atticus88/SAINTCON-2015-Badge/saintcon2015-badge-lua/src/archive/README.md

Currently unused code that may still be useful. Most of this will be purged before going public with the code.
