atticus88/SAINTCON-2015-Badge/badge-2015/common/components/wifi/winc1500/firmware_update_project/firmware/Tools/gain_builder/gain_sheets/default_gain_setting.csv

ch | 1 | 2 | 3 | 4 | 5 | 6 | 7 | 8 | 9 | 10 | 11 | 12 | 13 | 14
1 | -11 | -11 | -11 | -11 | -11 | -11 | -11 | -11 | -11 | -11 | -11 | -11 | -11 | -11
2 | -11 | -11 | -11 | -11 | -11 | -11 | -11 | -11 | -11 | -11 | -11 | -11 | -11 | -11
5.5 | -10 | -10 | -10 | -10 | -10 | -10 | -10 | -10 | -10 | -10 | -10 | -10 | -10 | -10
11 | -10 | -10 | -10 | -10 | -10 | -10 | -10 | -10 | -10 | -10 | -10 | -10 | -10 | -10
6 | -6 | -6 | -6 | -6 | -6 | -6 | -6 | -6 | -6 | -6 | -6 | -6 | -6 | -6
9 | -6 | -6 | -6 | -6 | -6 | -6 | -6 | -6 | -6 | -6 | -6 | -6 | -6 | -6
12 | -6 | -6 | -6 | -6 | -6 | -6 | -6 | -6 | -6 | -6 | -6 | -6 | -6 | -6
18 | -6 | -6 | -6 | -6 | -6 | -6 | -6 | -6 | -6 | -6 | -6 | -6 | -6 | -6
24 | -6 | -6 | -6 | -6 | -6 | -6 | -6 | -6 | -6 | -6 | -6 | -6 | -6 | -6
36 | -8 | -8 | -8 | -8 | -8 | -8 | -8 | -8 | -8 | -8 | -8 | -8 | -8 | -8
48 | -10 | -10 | -10 | -10 | -10 | -10 | -10 | -10 | -10 | -10 | -10 | -10 | -10 | -10
54 | -10 | -10 | -10 | -10 | -10 | -10 | -10 | -10 | -10 | -10 | -10 | -10 | -10 | -10
mcs0 | -6 | -6 | -6 | -6 | -6 | -6 | -6 | -6 | -6 | -6 | -6 | -6 | -6 | -6
mcs1 | -6 | -6 | -6 | -6 | -6 | -6 | -6 | -6 | -6 | -6 | -6 | -6 | -6 | -6
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
