atticus88/SAINTCON-2015-Badge/badge-2015/common/components/wifi/winc1500/firmware_update_project/firmware/Tools/gain_builder/gain_sheets/samw25_gain_setting.csv

ch | 1 | 2 | 3 | 4 | 5 | 6 | 7 | 8 | 9 | 10 | 11 | 12 | 13 | 14
1 | -11.5 | -10 | -10 | -10 | -10 | -10 | -10 | -10 | -10 | -10 | -10 | -10 | -10.5 | -10.5
2 | -11.5 | -10 | -10 | -10 | -10 | -10 | -10 | -10 | -10 | -10 | -10 | -10 | -10.5 | -10.5
5.5 | -11.5 | -10 | -10 | -10 | -10 | -10 | -10 | -10 | -10 | -10 | -10 | -10 | -10.5 | -10.5
11 | -11.5 | -10 | -10 | -10 | -10 | -10 | -10 | -10 | -10 | -10 | -10 | -10 | -10.5 | -10.5
6 | -10 | -9.5 | -9.5 | -9.5 | -9.5 | -9.5 | -9.5 | -9.5 | -9.5 | -9.5 | -9.5 | -9.5 | -10 | -10
9 | -10 | -9.5 | -9.5 | -9.5 | -9.5 | -9.5 | -9.5 | -9.5 | -9.5 | -9.5 | -9.5 | -9.5 | -10 | -10
12 | -10 | -9.5 | -9.5 | -9.5 | -9.5 | -9.5 | -9.5 | -9.5 | -9.5 | -9.5 | -9.5 | -9.5 | -10 | -10
18 | -10 | -9.5 | -9.5 | -9.5 | -9.5 | -9.5 | -9.5 | -9.5 | -9.5 | -9.5 | -9.5 | -9.5 | -10 | -10
24 | -10 | -9.5 | -9.5 | -9.5 | -9.5 | -9.5 | -9.5 | -9.5 | -9.5 | -9.5 | -9.5 | -9.5 | -10 | -10
36 | -10 | -9.5 | -9.5 | -9.5 | -9.5 | -9.5 | -9.5 | -9.5 | -9.5 | -9.5 | -9.5 | -9.5 | -10 | -10
48 | -10 | -9.5 | -9.5 | -9.5 | -9.5 | -9.5 | -9.5 | -9.5 | -9.5 | -9.5 | -9.5 | -9.5 | -10 | -10
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
