atticus88/SAINTCON-2015-Badge/hardware/SaintCon2015Badge-20150830-sch.pdf

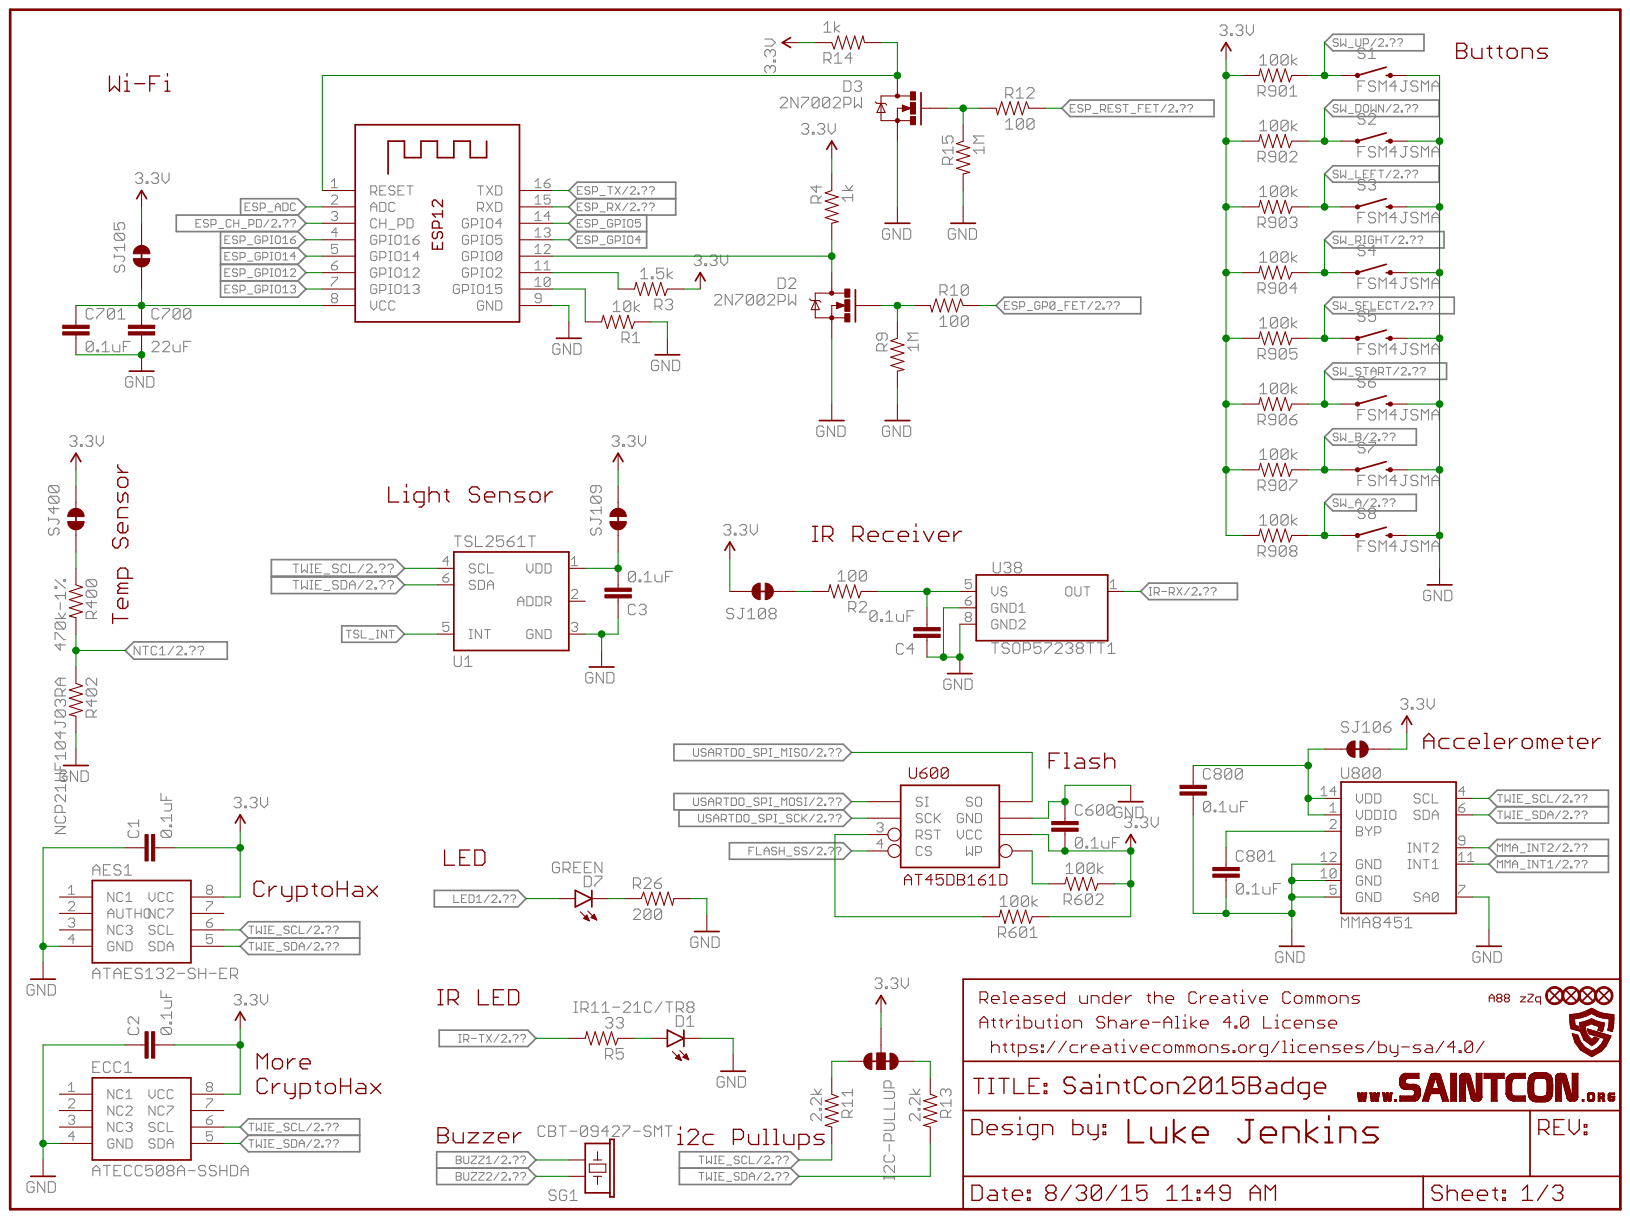
[picture p1: page 1]

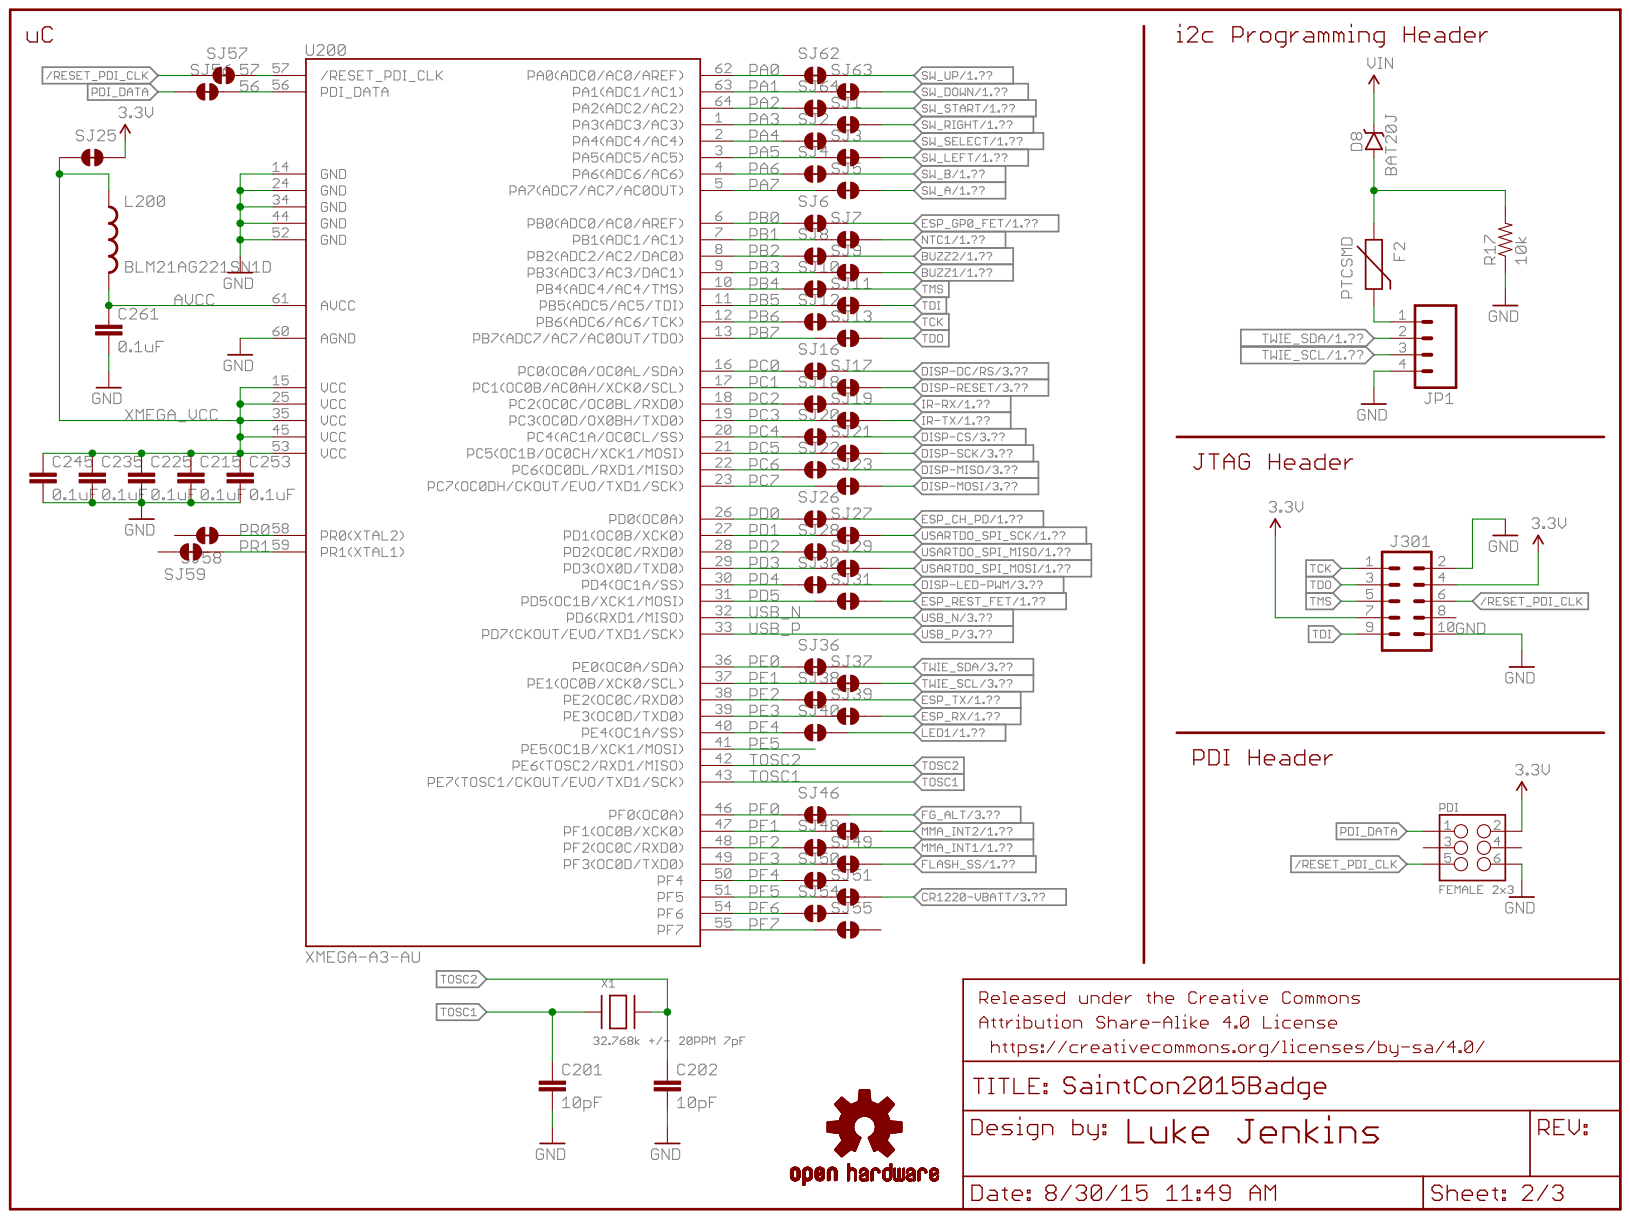
[picture p2: page 2]

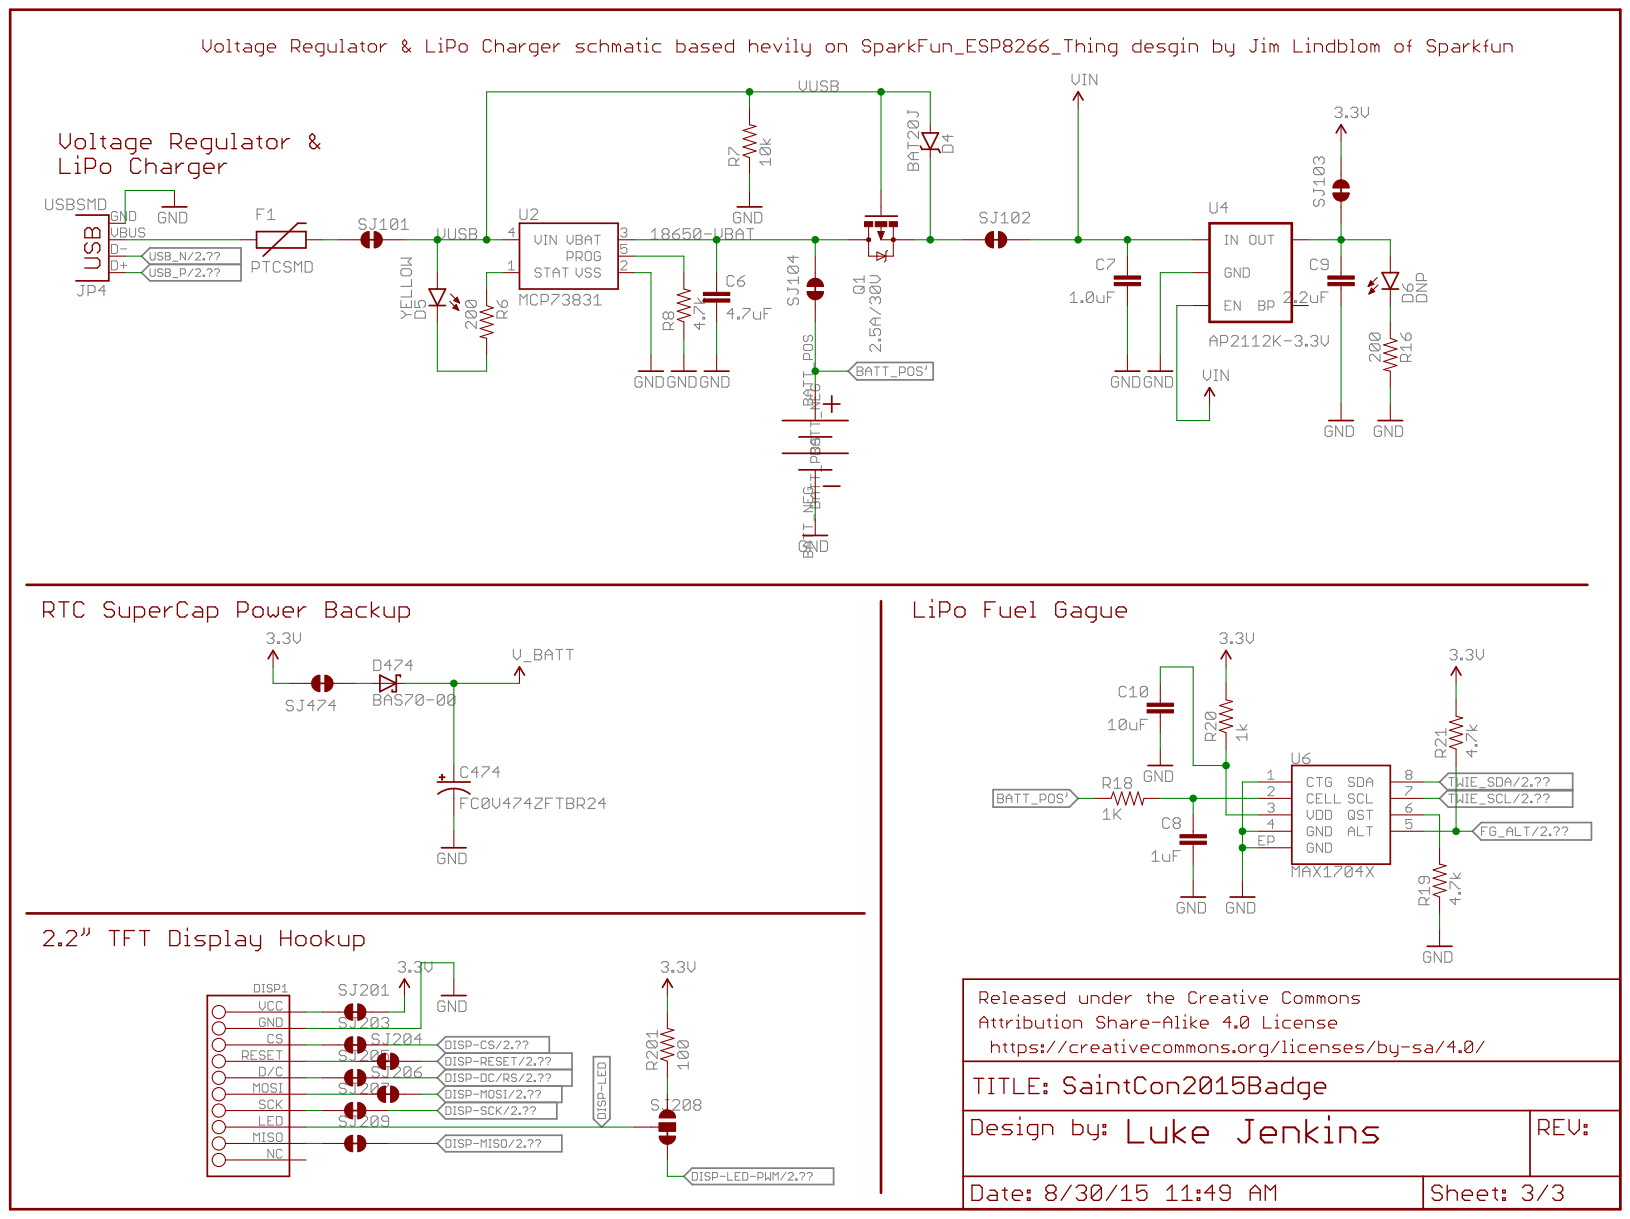
[picture p3: page 3]
