atticus88/SAINTCON-2015-Badge/hardware/SaintCon2015Badge.brd

## EAGLE design hardware/SaintCon2015Badge.brd (2015-10-31)

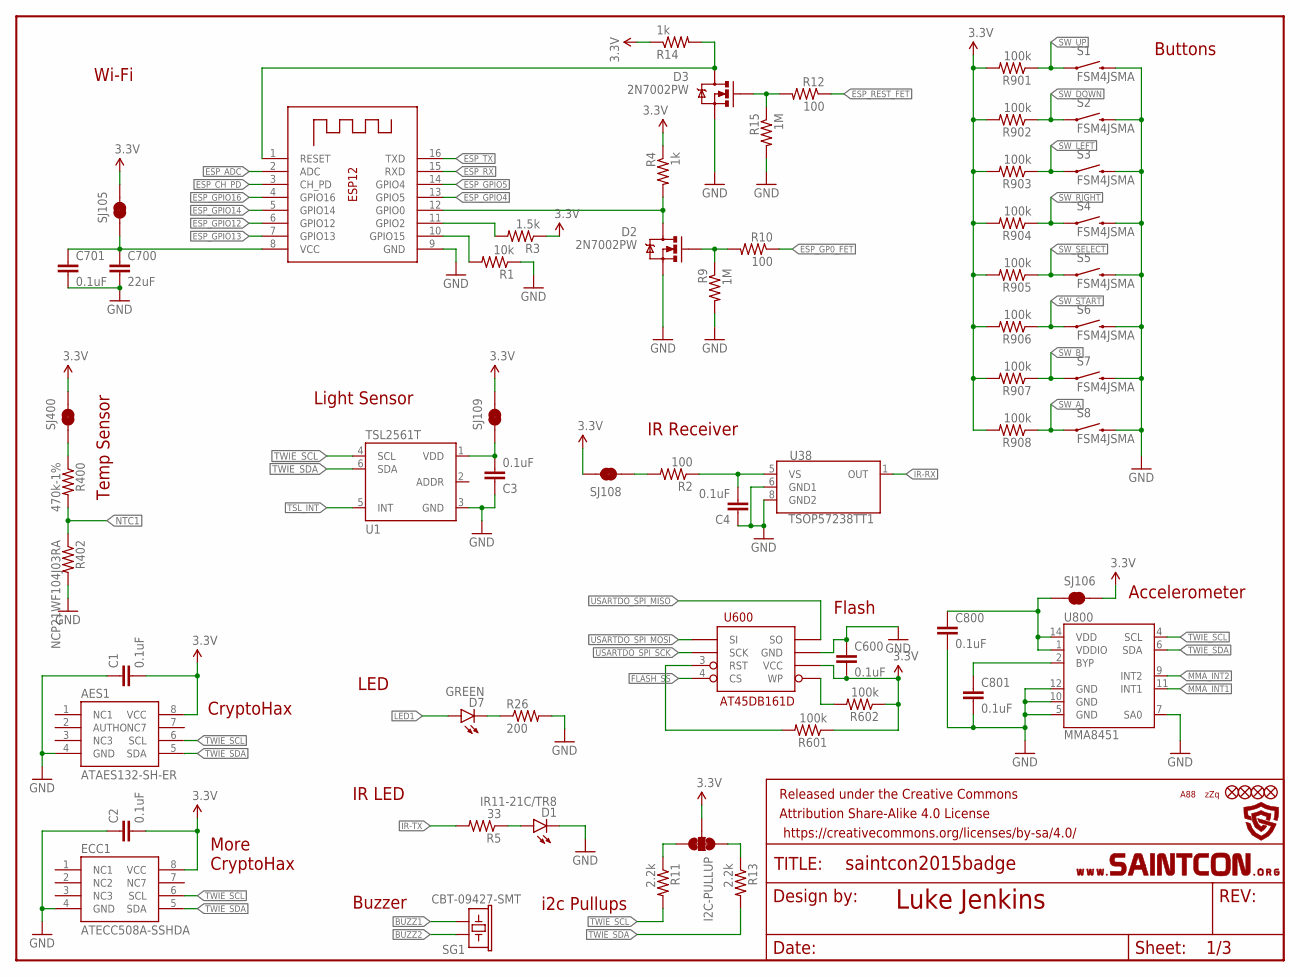
[picture p4: schematic SaintCon2015Badge.sch, sheet 1]

Parts:
AES1: ATAES132-SH-ER; SOIC8
C1, C2, C3, C4, C600, C701, C800, C801: 0.1uF; 0805
C700: 22uF; 0805
D1: IR11-21C/TR8; LED-1206
D2, D3: 2N7002PW; SOT323
D7: GREEN; LED-1206
ECC1: ATECC508A-SSHDA; SOIC8
ESP12: ESP12; ESP-12
FID1, FID2, FID3, FID4: FIDUCIAL1X2; FIDUCIAL-1X2
FRAME3: FRAME-LETTERNO_PACKAGE; DUMMY
I2C-PULLUP: JUMPER-PAD-3-NC_BY_TRACE; PAD-JUMPER-3-3OF3_NC_BY_TRACE_YES_SILK_FULL_BOX
R1: 10k; 0805
R2, R10, R12: 100; 0805
R3: 1.5k; 0805
R4, R14: 1k; 0805
R5: 33; 0805
R9, R15: 1M; 0805
R11, R13: 2.2k; 0805
R26: 200; 0805
R400: 470k-1%; 0805
R402: NCP21WF104J03RA; 0805
R601, R602, R901, R902, R903, R904, R905, R906, R907, R908: 100k; 0805
S1, S2, S3, S4, S5, S6, S7, S8: FSM4JSMA; TACTILE_SWITCH_ZZQ
SG1: CBT-09427-SMT; BUZZER-CCV-KIT
SJ105, SJ106, SJ108, SJ109, SJ400: JUMPER-PAD-2-NC_BY_TRACE; PAD-JUMPER-2-NC_BY_TRACE_YES_SILK
U1: TSL2561T; TMB-6
U38: TSOP57238TT1; TSOP572
U600: AT45DB161D; SO08-EIAJ
U800: MMA8451; QFN-16_0.5MM
U$1: AZZQ
U$2: A88
U$4: SAINTCON-LOGO
U$5: SAINTCON-HEADER

Connections:
3.3V: AES1.8 (VCC), C1.2, C2.2, C600.2, ECC1.8 (VCC), I2C-PULLUP.2, R3.1, R4.1, R14.1, R601.1, R602.1, R901.2, R902.2, R903.2, R904.2, R905.2, R906.2, R907.2, R908.2, SJ105.2, SJ106.2, SJ108.2, SJ109.2, SJ400.2, U600.6 (VCC); also elsewhere on the board
AT45-/RST: R601.2, U600.3 (RST)
AT45-/WP: R602.2, U600.5 (WP)
BUZZ1: SG1.+ (1); also elsewhere on the board
BUZZ2: SG1.- (2); also elsewhere on the board
D7-R26: D7.C, R26.1
ESP_ADC: ESP12.2 (ADC)
ESP_CH_PD: ESP12.3 (CH_PD); also elsewhere on the board
ESP_GP0_FET: R10.1; also elsewhere on the board
ESP_GPIO0: D2.3 (D), ESP12.12 (GPIO0), R4.2
ESP_GPIO0_FET_GATE: D2.1 (G), R9.1, R10.2
ESP_GPIO2: ESP12.11 (GPIO2), R3.2
ESP_GPIO4: ESP12.13 (GPIO5)
ESP_GPIO5: ESP12.14 (GPIO4)
ESP_GPIO12: ESP12.6 (GPIO12)
ESP_GPIO13: ESP12.7 (GPIO13)
ESP_GPIO14: ESP12.5 (GPIO14)
ESP_GPIO15: ESP12.10 (GPIO15), R1.2
ESP_GPIO16: ESP12.4 (GPIO16)
ESP_REST: D3.3 (D), ESP12.1 (RESET), R14.2
ESP_REST_FET: R12.1; also elsewhere on the board
ESP_REST_FET_GATE: D3.1 (G), R12.2, R15.1
ESP_RX: ESP12.15 (RXD); also elsewhere on the board
ESP_TX: ESP12.16 (TXD); also elsewhere on the board
ESP_VCC: C700.1, C701.1, ESP12.8 (VCC), SJ105.1
FLASH_SS: U600.4 (CS); also elsewhere on the board
GND: AES1.4 (GND), C1.1, C2.1, C3.1, C4.1, C600.1, C700.2, C701.2, C800.2, C801.2, D1.C, D2.2 (S), D3.2 (S), ECC1.4 (GND), ESP12.9 (GND), R1.1, R9.2, R15.2, R26.2, R402.2, S1.B2 (2), S2.B2 (2), S3.B2 (2), S4.B2 (2), S5.B2 (2), S6.B2 (2), S7.B2 (2), S8.B2 (2), U1.3 (GND), U38.6 (GND1), U38.8 (GND2), U600.7 (GND), U800.5 (GND), U800.7 (SA0), U800.10 (GND), U800.12 (GND); also elsewhere on the board
IR-RX: U38.1 (OUT); also elsewhere on the board
IR-RX-VS: C4.2, R2.1, U38.5 (VS)
IR-TX: R5.2; also elsewhere on the board
IR-TX-R: D1.A, R5.1
LED1: D7.A; also elsewhere on the board
MMA8451-BYP: C801.1, U800.2 (BYP)
MMA_INT1: U800.11 (INT1); also elsewhere on the board
MMA_INT2: U800.9 (INT2); also elsewhere on the board
MMA_VCC: C800.1, SJ106.1, U800.1 (VDDIO), U800.14 (VDD)
NTC1: R400.2, R402.1; also elsewhere on the board
R2-IN: R2.2, SJ108.1
R11-IN: I2C-PULLUP.3, R11.1
R13-IN: I2C-PULLUP.1, R13.1
R400-SJ400: R400.1, SJ400.1
SW_A: R908.1, S8.A2 (1); also elsewhere on the board
SW_B: R907.1, S7.A2 (1); also elsewhere on the board
SW_DOWN: R902.1, S2.A2 (1); also elsewhere on the board
SW_LEFT: R903.1, S3.A2 (1); also elsewhere on the board
SW_RIGHT: R904.1, S4.A2 (1); also elsewhere on the board
SW_SELECT: R905.1, S5.A2 (1); also elsewhere on the board
SW_START: R906.1, S6.A2 (1); also elsewhere on the board
SW_UP: R901.1, S1.A2 (1); also elsewhere on the board
TSL2561-VDD: C3.2, SJ109.1, U1.1 (VDD)
TSL_INT: U1.5 (INT)
TWIE_SCL: AES1.6 (SCL), ECC1.6 (SCL), R11.2, U1.4 (SCL), U800.4 (SCL); also elsewhere on the board
TWIE_SDA: AES1.5 (SDA), ECC1.5 (SDA), R13.2, U1.6 (SDA), U800.6 (SDA); also elsewhere on the board
USARTDO_SPI_MISO: U600.8 (SO); also elsewhere on the board
USARTDO_SPI_MOSI: U600.1 (SI); also elsewhere on the board
USARTDO_SPI_SCK: U600.2 (SCK); also elsewhere on the board

Notes on the sheet:
Luke Jenkins
Wi-Fi
Temp Sensor
CryptoHax
LED
IR LED
i2c Pullups
Buzzer
Accelerometer
Flash
Light Sensor
IR Receiver
Buttons
More CryptoHax

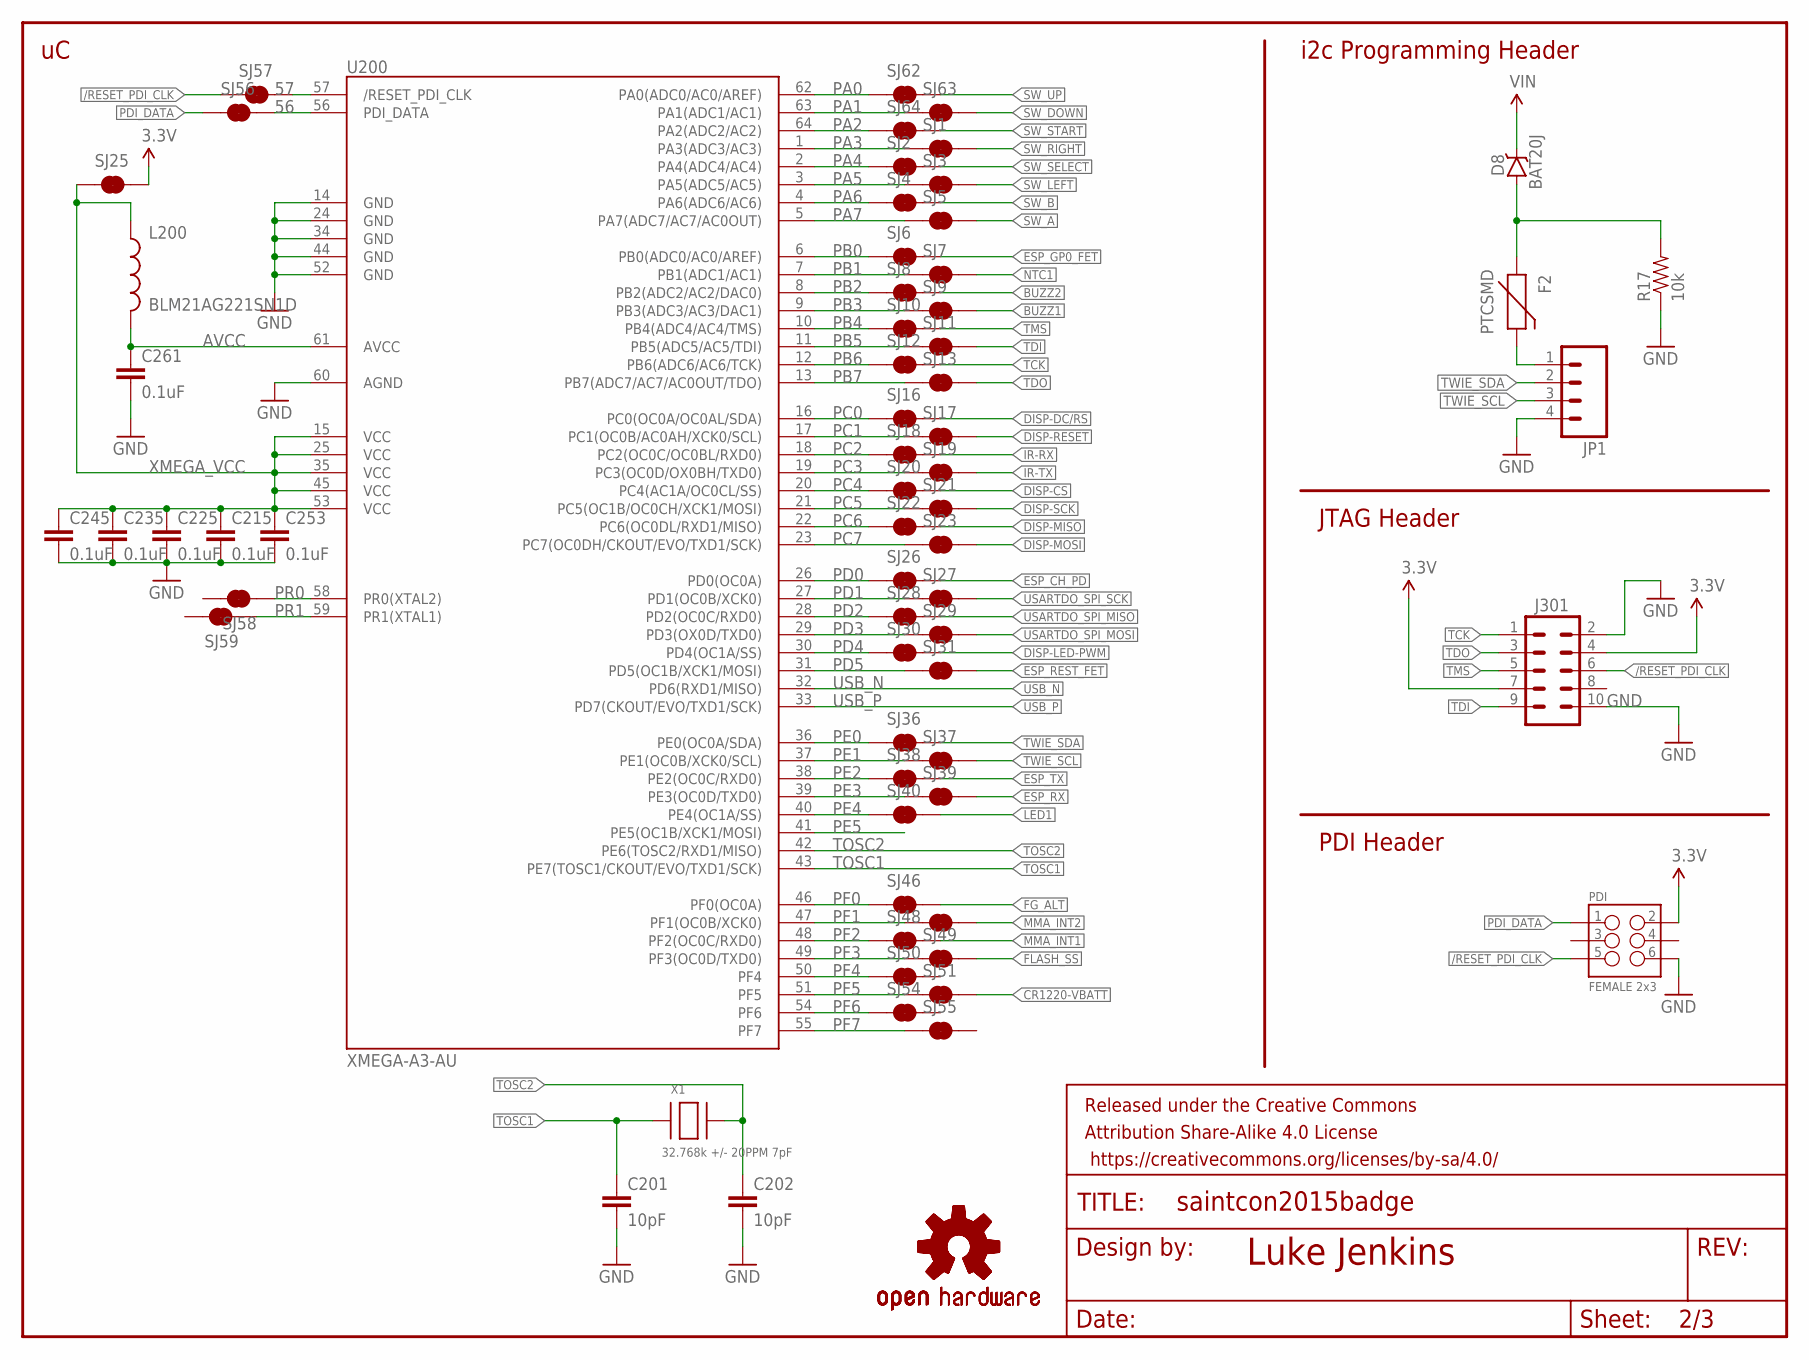
[picture p5: schematic SaintCon2015Badge.sch, sheet 2]

Parts:
C201, C202: 10pF; 0805
C215, C225, C235, C245, C253, C261: 0.1uF; 0805
D8: BAT20J; SOD-323
F2: PTCSMD; PTC-1206
FRAME1: FRAME-LETTERNO_PACKAGE; DUMMY
J301: M05X2PTH; AVR_ICSP
JP1: M04PTH; 1X04
L200: BLM21AG221SN1D; 0805
LOGO1: OSHW-LOGOS-COPPER; OSHW-LOGO-S_COPPER
LOGO2: OSHW-LOGOS; OSHW-LOGO-S
PDI: FEMALE 2x3; 2X3
R17: 10k; 0805
SJ1, SJ2, SJ3, SJ4, SJ5, SJ6, SJ7, SJ8, SJ9, SJ10, SJ11, SJ12, SJ13, SJ16, SJ17, SJ18, SJ19, SJ20, SJ21, SJ22, SJ23, SJ25, SJ26, SJ27, SJ28, SJ29, SJ30, SJ31, SJ36, SJ37, SJ38, SJ39, SJ40, SJ46, SJ47, SJ48, SJ49, SJ50, SJ51, SJ54, SJ55, SJ56, SJ57, SJ58, SJ59, SJ62, SJ63, SJ64: JUMPER-PAD-2-NC_BY_TRACE; PAD-JUMPER-2-NC_BY_TRACE_YES_SILK
U200: XMEGA-A3-AU; TQFP64_14X14MM
X1: 32.768k +/- 20PPM 7pF; XTAL3215

Connections:
3.3V: J301.4, J301.7, PDI.2, SJ25.2; also elsewhere on the board
56: SJ56.2, U200.56 (PDI_DATA)
57: SJ57.2, U200.57 (/RESET_PDI_CLK)
/RESET_PDI_CLK: J301.6, PDI.5, SJ57.1
AVCC: C261.1, L200.2, U200.61 (AVCC)
BUZZ1: SJ9.2; also elsewhere on the board
BUZZ2: SJ8.2; also elsewhere on the board
CR1220-VBATT: SJ51.2; also elsewhere on the board
DISP-CS: SJ20.2; also elsewhere on the board
DISP-DC/RS: SJ16.2; also elsewhere on the board
DISP-LED-PWM: SJ30.2; also elsewhere on the board
DISP-MISO: SJ22.2; also elsewhere on the board
DISP-MOSI: SJ23.2; also elsewhere on the board
DISP-RESET: SJ17.2; also elsewhere on the board
DISP-SCK: SJ21.2; also elsewhere on the board
ESP_CH_PD: SJ26.2; also elsewhere on the board
ESP_GP0_FET: SJ6.2; also elsewhere on the board
ESP_REST_FET: SJ31.2; also elsewhere on the board
ESP_RX: SJ39.2; also elsewhere on the board
ESP_TX: SJ38.2; also elsewhere on the board
F2-D8-R17: D8.A, F2.1, R17.2
FG_ALT: SJ46.2; also elsewhere on the board
FLASH_SS: SJ49.2; also elsewhere on the board
GND: C201.2, C202.2, C215.2, C225.2, C235.2, C245.2, C253.2, C261.2, J301.2, J301.10, JP1.4, PDI.6, R17.1, U200.14 (GND1), U200.24 (GND2), U200.34 (GND3), U200.44 (GND4), U200.52 (GND5), U200.60 (AGND); also elsewhere on the board
IR-RX: SJ18.2; also elsewhere on the board
IR-TX: SJ19.2; also elsewhere on the board
J1-F2: F2.2, JP1.1
LED1: SJ40.2; also elsewhere on the board
MMA_INT1: SJ48.2; also elsewhere on the board
MMA_INT2: SJ47.2; also elsewhere on the board
NTC1: SJ7.2; also elsewhere on the board
PA0: SJ62.1, U200.62 (PA0(ADC0/AC0/AREF))
PA1: SJ63.1, U200.63 (PA1(ADC1/AC1))
PA2: SJ64.1, U200.64 (PA2(ADC2/AC2))
PA3: SJ1.1, U200.1 (PA3(ADC3/AC3))
PA4: SJ2.1, U200.2 (PA4(ADC4/AC4))
PA5: SJ3.1, U200.3 (PA5(ADC5/AC5))
PA6: SJ4.1, U200.4 (PA6(ADC6/AC6))
PA7: SJ5.1, U200.5 (PA7(ADC7/AC7/AC0OUT))
PB0: SJ6.1, U200.6 (PB0(ADC0/AC0/AREF))
PB1: SJ7.1, U200.7 (PB1(ADC1/AC1))
PB2: SJ8.1, U200.8 (PB2(ADC2/AC2/DAC0))
PB3: SJ9.1, U200.9 (PB3(ADC3/AC3/DAC1))
PB4: SJ10.1, U200.10 (PB4(ADC4/AC4/TMS))
PB5: SJ11.1, U200.11 (PB5(ADC5/AC5/TDI))
PB6: SJ12.1, U200.12 (PB6(ADC6/AC6/TCK))
PB7: SJ13.1, U200.13 (PB7(ADC7/AC7/AC0OUT/TDO))
PC0: SJ16.1, U200.16 (PC0(OC0A/OC0AL/SDA))
PC1: SJ17.1, U200.17 (PC1(OC0B/AC0AH/XCK0/SCL))
PC2: SJ18.1, U200.18 (PC2(OC0C/OC0BL/RXD0))
PC3: SJ19.1, U200.19 (PC3(OC0D/OX0BH/TXD0))
PC4: SJ20.1, U200.20 (PC4(AC1A/OC0CL/SS))
PC5: SJ21.1, U200.21 (PC5(OC1B/OC0CH/XCK1/MOSI))
PC6: SJ22.1, U200.22 (PC6(OC0DL/RXD1/MISO))
PC7: SJ23.1, U200.23 (PC7(OC0DH/CKOUT/EVO/TXD1/SCK))
PD0: SJ26.1, U200.26 (PD0(OC0A))
PD1: SJ27.1, U200.27 (PD1(OC0B/XCK0))
PD2: SJ28.1, U200.28 (PD2(OC0C/RXD0))
PD3: SJ29.1, U200.29 (PD3(OX0D/TXD0))
PD4: SJ30.1, U200.30 (PD4(OC1A/SS))
PD5: SJ31.1, U200.31 (PD5(OC1B/XCK1/MOSI))
PDI_DATA: PDI.1, SJ56.1
PE0: SJ36.1, U200.36 (PE0(OC0A/SDA))
PE1: SJ37.1, U200.37 (PE1(OC0B/XCK0/SCL))
PE2: SJ38.1, U200.38 (PE2(OC0C/RXD0))
PE3: SJ39.1, U200.39 (PE3(OC0D/TXD0))
PE4: SJ40.1, U200.40 (PE4(OC1A/SS))
PE5: U200.41 (PE5(OC1B/XCK1/MOSI))
PF0: SJ46.1, U200.46 (PF0(OC0A))
PF1: SJ47.1, U200.47 (PF1(OC0B/XCK0))
PF2: SJ48.1, U200.48 (PF2(OC0C/RXD0))
PF3: SJ49.1, U200.49 (PF3(OC0D/TXD0))
PF4: SJ50.1, U200.50 (PF4)
PF5: SJ51.1, U200.51 (PF5)
PF6: SJ54.1, U200.54 (PF6)
PF7: SJ55.1, U200.55 (PF7)
PR0: SJ58.1, U200.58 (PR0(XTAL2))
PR1: SJ59.1, U200.59 (PR1(XTAL1))
SW_A: SJ5.2; also elsewhere on the board
SW_B: SJ4.2; also elsewhere on the board
SW_DOWN: SJ63.2; also elsewhere on the board
SW_LEFT: SJ3.2; also elsewhere on the board
SW_RIGHT: SJ1.2; also elsewhere on the board
SW_SELECT: SJ2.2; also elsewhere on the board
SW_START: SJ64.2; also elsewhere on the board
SW_UP: SJ62.2; also elsewhere on the board
TCK: J301.1, SJ12.2
TDI: J301.9, SJ11.2
TDO: J301.3, SJ13.2
TMS: J301.5, SJ10.2
TOSC1: C201.1, U200.43 (PE7(TOSC1/CKOUT/EVO/TXD1/SCK)), X1.P$1
TOSC2: C202.1, U200.42 (PE6(TOSC2/RXD1/MISO)), X1.P$2
TWIE_SCL: JP1.3, SJ37.2; also elsewhere on the board
TWIE_SDA: JP1.2, SJ36.2; also elsewhere on the board
USARTDO_SPI_MISO: SJ28.2; also elsewhere on the board
USARTDO_SPI_MOSI: SJ29.2; also elsewhere on the board
USARTDO_SPI_SCK: SJ27.2; also elsewhere on the board
USB_N: U200.32 (PD6(RXD1/MISO)); also elsewhere on the board
USB_P: U200.33 (PD7(CKOUT/EVO/TXD1/SCK)); also elsewhere on the board
VIN: D8.C; also elsewhere on the board
XMEGA_VCC: C215.1, C225.1, C235.1, C245.1, C253.1, L200.1, SJ25.1, U200.15 (VCC1), U200.25 (VCC2), U200.35 (VCC3), U200.45 (VCC4), U200.53 (VCC5)

Notes on the sheet:
Luke Jenkins
i2c Programming Header
JTAG Header
PDI Header

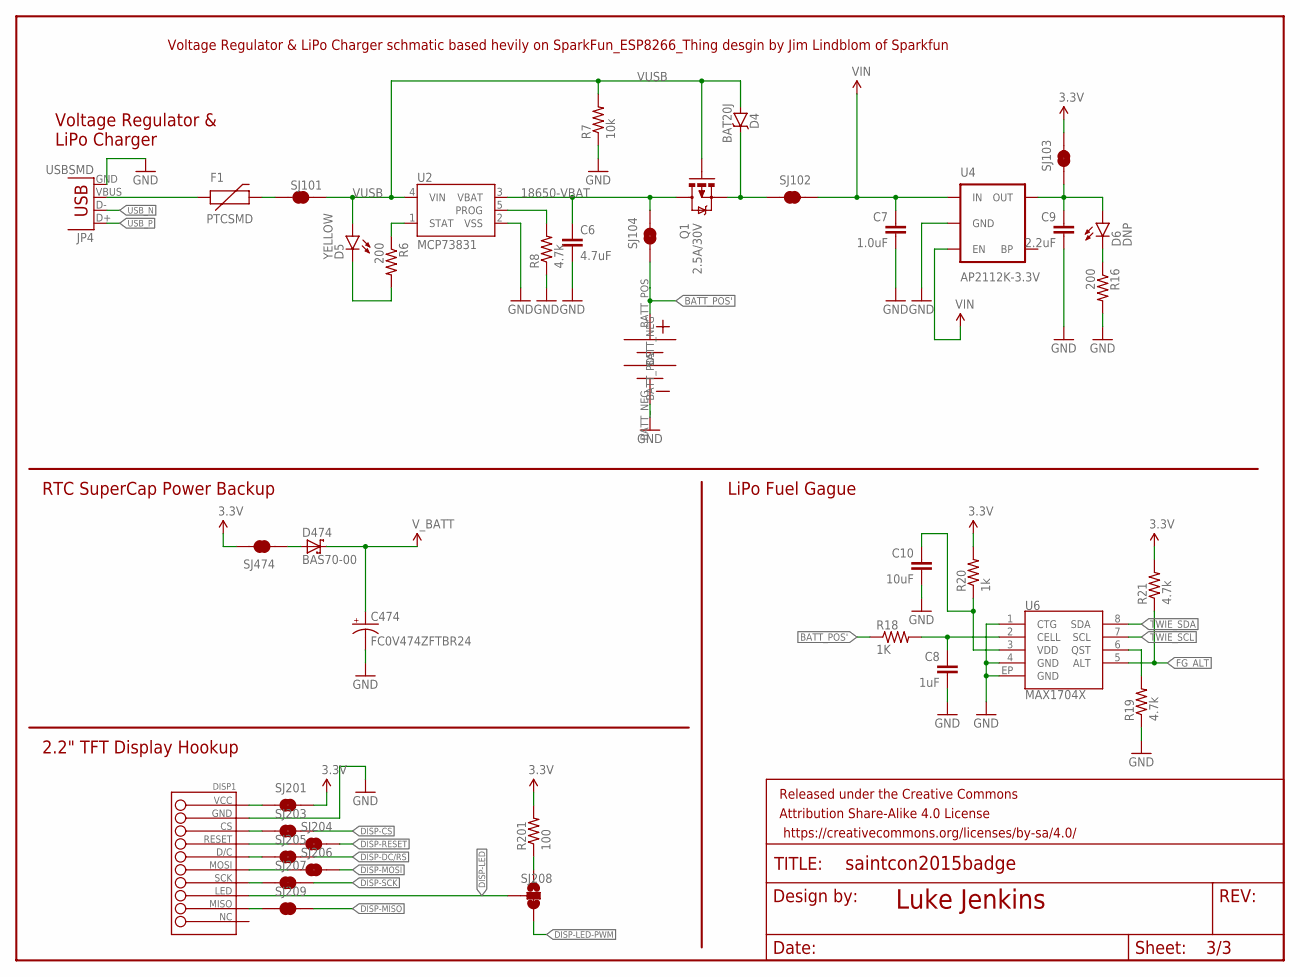
[picture p6: schematic SaintCon2015Badge.sch, sheet 3]

Parts:
BATT2: 1042P
C6: 4.7uF; 0805
C7: 1.0uF; 0805
C8: 1uF; 0805
C9: 2.2uF; 0805
C10: 10uF; 0805
C474: FC0V474ZFTBR24; 153CLV-1014
D4: BAT20J; SOD-323
D5: YELLOW; LED-1206
D6: DNP; LED-1206
D474: BAS70-00; SOT23
DISP1: TFT22FEMALE_SMD; TFT22
F1: PTCSMD; PTC-1206
FRAME2: FRAME-LETTERNO_PACKAGE; DUMMY
JP4: USBSMD; USB-MINIB
Q1: 2.5A/30V; SOT23-3
R6, R16: 200; 0805
R7: 10k; 0805
R8, R19, R21: 4.7k; 0805
R18: 1K; 0805
R20: 1k; 0805
R201: 100; 0805
SJ101, SJ102, SJ103, SJ104, SJ201, SJ203, SJ204, SJ205, SJ206, SJ207, SJ209, SJ474: JUMPER-PAD-2-NC_BY_TRACE; PAD-JUMPER-2-NC_BY_TRACE_YES_SILK
SJ208: JUMPER-PAD-3-2OF3_NC_BY_TRACE_SMALL; PAD-JUMPER-3-2OF3_NC_BY_TRACE_YES_SILK_FULL_BOX
U2: MCP73831; SOT23-5
U4: AP2112K-3.3V; SOT23-5
U6: MAX1704X; TDFN-8

Connections:
3.3V: R20.2, R21.2, R201.2, SJ103.2, SJ201.2, SJ474.2; also elsewhere on the board
18650-VBAT: C6.1, Q1.3 (D), SJ104.2, U2.3 (VBAT)
BATT_POS': BATT2.BATT_POS, R18.1, SJ104.1
CR1220-VBATT: C474.+, D474.3 (C); also elsewhere on the board
D4-OUT: D4.C, Q1.2 (S), SJ102.1
D5-R6: D5.C, R6.2
D6-R16: D6.C, R16.1
DISP1-CS: DISP1.CS (3), SJ203.1
DISP1-D/C: DISP1.D/C (5), SJ205.1
DISP1-MISO: DISP1.MISO (9), SJ209.1
DISP1-MOSI: DISP1.MOSI (6), SJ206.1
DISP1-RESET: DISP1.RESET (4), SJ204.1
DISP1-SCK: DISP1.SCK (7), SJ207.1
DISP1-VCC: DISP1.VCC, SJ201.1
DISP-CS: SJ203.2; also elsewhere on the board
DISP-DC/RS: SJ205.2; also elsewhere on the board
DISP-LED: DISP1.LED (8), SJ208.2
DISP-LED-100: R201.1, SJ208.1
DISP-LED-PWM: SJ208.3; also elsewhere on the board
DISP-MISO: SJ209.2; also elsewhere on the board
DISP-MOSI: SJ206.2; also elsewhere on the board
DISP-RESET: SJ204.2; also elsewhere on the board
DISP-SCK: SJ207.2; also elsewhere on the board
F1-SJ: F1.2, SJ101.1
FG_ALT: R21.1, U6.5 (ALT); also elsewhere on the board
FG_CELL: C8.1, R18.2, U6.2 (CELL)
FG_QST: R19.2, U6.6 (QST)
FG_VDD: C10.1, R20.1, U6.3 (VDD)
GND: BATT2.BATT_NEG, C6.2, C7.2, C8.2, C9.2, C10.2, C474.-, DISP1.GND (2), JP4.GND, R7.1, R8.1, R16.2, R19.1, U2.2 (VSS), U4.2 (GND), U6.1 (CTG), U6.4 (GND), U6.EP (GND); also elsewhere on the board
MCP73831-PROG: R8.2, U2.5 (PROG)
MCP73831-STAT: R6.1, U2.1 (STAT)
REG_OUT: C9.1, D6.A, SJ103.1, U4.5 (OUT)
SJ474-D474: D474.1 (A), SJ474.1
TWIE_SCL: U6.7 (SCL); also elsewhere on the board
TWIE_SDA: U6.8 (SDA); also elsewhere on the board
USB-F1: F1.1, JP4.VBUS
USB_N: JP4.D-; also elsewhere on the board
USB_P: JP4.D+; also elsewhere on the board
VIN: C7.1, SJ102.2, U4.1 (IN), U4.3 (EN); also elsewhere on the board
VUSB: D4.A, D5.A, Q1.1 (G), R7.2, SJ101.2, U2.4 (VIN)

Notes on the sheet:
Voltage Regulator & LiPo Charger
Luke Jenkins
Voltage Regulator & LiPo Charger schmatic based hevily on SparkFun_ESP8266_Thing desgin by Jim Lindblom of Sparkfun
RTC SuperCap Power Backup
2.2" TFT Display Hookup
LiPo Fuel Gague

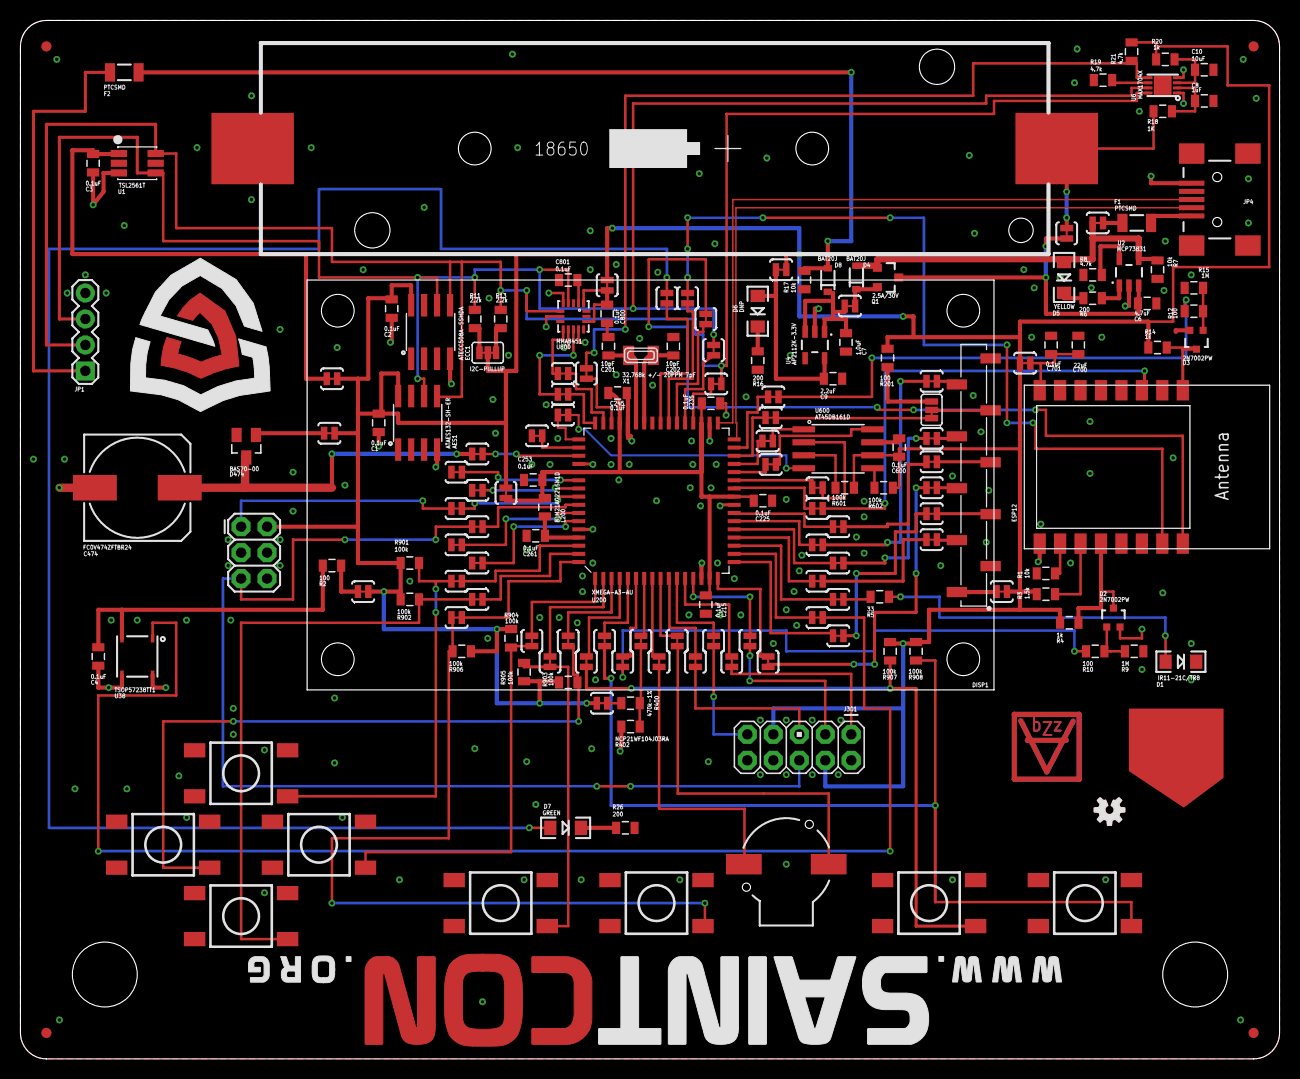
[picture p7: board SaintCon2015Badge.brd from above]

Board: 2 copper layers, 123.2 x 101.6 mm, 178 parts (0 on the bottom side), 143 nets.
