atticus88/SAINTCON-2015-Badge/badge-2015/app/config/conf_sysfont.h

/**
 * \file
 *
 * \brief Default configurations for sysfont
 *
 * Copyright (c) 2014-2015 Atmel Corporation. All rights reserved.
 *
 * \asf_license_start
 *
 * \page License
 *
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
 * 3. The name of Atmel may not be used to endorse or promote products derived
 *    from this software without specific prior written permission.
 *
 * 4. This software may only be redistributed and used in connection with an
 *    Atmel microcontroller product.
 *
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
 * \asf_license_stop
 *
 */
/*
 * Support and FAQ: visit <a href="http://www.atmel.com/design-support/">Atmel Support</a>
 */
#ifndef CONF_SYSFONT_H
#define CONF_SYSFONT_H

/**
 * \weakgroup gfx_sysfont
 * @{
 */
#define SYMFONT_NAMETAG " "
#define SYMFONT_BATTERY "!"
#define SYMFONT_BELL "\""
#define SYMFONT_SCHEDULE "#"
#define SYMFONT_GEAR "$"
#define SYMFONT_POWER "%"
#define SYMFONT_HUMAN "&"
#define SYMFONT_NAV "'"
#define SYMFONT_LIGHTNING "("
#define SYMFONT_CONTROLLER ")"
#define SYMFONT_GAUGE "*"
#define SYMFONT_GLOBE "+"
#define SYMFONT_MAIL ","
#define SYMFONT_CROSSHAIR "-"
#define SYMFONT_QUESTION "."
#define SYMFONT_INFO "/"
#define SYMFONT_LOCATION "0"
#define SYMFONT_MAP "1"
#define SYMFONT_EXCLIMATION "2"
#define SYMFONT_PLUG "3"
#define SYMFONT_MOON "4"
#define SYMFONT_WIFI "5"
#define SYMFONT_LEVERS "6"
#define SYMFONT_BULD "7"
#define SYMFONT_HC "8"

#include <stdint.h>

// #define USE_FONT_BPMONO_10x16
// #if defined(USE_FONT_BPMONO_10x16)

/** First character defined. */
#define SYSFONT_FIRSTCHAR       ((uint8_t)' ')
/** Last character defined. */
#define SYSFONT_LASTCHAR        ((uint8_t)'}')
#define SYSFONT_LINESPACING     20



/** Width of each glyph, including spacer column. */
#define SYSFONT_WIDTH           		10
#define SYSFONT_HEIGHT          		21

#define SYSFONT_TINY_WIDTH           	8
#define SYSFONT_TINY_HEIGHT          	16

#define SYSFONT_SMALL_WIDTH           	9
#define SYSFONT_SMALL_HEIGHT          	20 

#define SYSFONT_MEDIUM_WIDTH           	13
#define SYSFONT_MEDIUM_HEIGHT          	29

#define SYSFONT_LARGE_WIDTH           	18
#define SYSFONT_LARGE_HEIGHT          	35

// #define SYSFONT_SYMBOL_WIDTH           	53
// #define SYSFONT_SYMBOL_HEIGHT          	53
#define SYSFONT_SYMBOL_WIDTH           		38
#define SYSFONT_SYMBOL_HEIGHT          		35


#define SYSFONT_DEFINE_TINY_GLYPHS static PROGMEM_DECLARE(uint8_t, sysfont_tiny_glyphs[]) = {\
0x00, 0x00, 0x00, 0x00, 0x00, 0x00, 0x00, 0x00, 0x00, 0x00, \
0x00, 0x00, 0x00, 0x00, 0x00, 0x00, /*   */ \
0x00, 0x00, 0x00, 0x00, 0x00, 0x10, 0x10, 0x10, 0x10, 0x10, \
0x10, 0x00, 0x10, 0x00, 0x00, 0x00, /* ! */ \
0x00, 0x00, 0x00, 0x00, 0x28, 0x28, 0x28, 0x00, 0x00, 0x00, \
0x00, 0x00, 0x00, 0x00, 0x00, 0x00, /* " */ \
0x00, 0x00, 0x00, 0x00, 0x00, 0x14, 0x28, 0xFC, 0x28, 0x50, \
0xFC, 0x50, 0xA0, 0x00, 0x00, 0x00, /* # */ \
0x00, 0x00, 0x00, 0x00, 0x10, 0x3C, 0x40, 0x40, 0x30, 0x18, \
0x04, 0x04, 0x78, 0x10, 0x00, 0x00, /* $ */ \
0x00, 0x00, 0x00, 0x00, 0x00, 0xE4, 0xA8, 0xB0, 0xF0, 0x3C, \
0x34, 0x54, 0x9C, 0x00, 0x00, 0x00, /* % */ \
0x00, 0x00, 0x00, 0x00, 0x00, 0x30, 0x48, 0x48, 0x70, 0x74, \
0x98, 0x88, 0x74, 0x00, 0x00, 0x00, /* & */ \
0x00, 0x00, 0x00, 0x00, 0x10, 0x10, 0x10, 0x00, 0x00, 0x00, \
0x00, 0x00, 0x00, 0x00, 0x00, 0x00, /* ' */ \
0x00, 0x00, 0x00, 0x00, 0x00, 0x08, 0x10, 0x20, 0x40, 0x40, \
0x40, 0x40, 0x20, 0x10, 0x08, 0x00, /* ( */ \
0x00, 0x00, 0x00, 0x00, 0x00, 0x20, 0x10, 0x08, 0x04, 0x04, \
0x04, 0x04, 0x08, 0x10, 0x20, 0x00, /* ) */ \
0x00, 0x00, 0x00, 0x00, 0x00, 0x10, 0x7C, 0x10, 0x28, 0x28, \
0x00, 0x00, 0x00, 0x00, 0x00, 0x00, /* * */ \
0x00, 0x00, 0x00, 0x00, 0x00, 0x00, 0x00, 0x10, 0x10, 0x7C, \
0x10, 0x10, 0x00, 0x00, 0x00, 0x00, /* + */ \
0x00, 0x00, 0x00, 0x00, 0x00, 0x00, 0x00, 0x00, 0x00, 0x00, \
0x00, 0x00, 0x10, 0x10, 0x20, 0x00, /* , */ \
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
0x00, 0x00, 0x00, 0x00, 0x00, 0x00, 0x00, 0x00, 0x00, 0x00, \
0x00, 0x1C, 0x00, 0x00, 0x00, 0x00, 0x3F, 0x80, 0x00, 0x00, \
0x00, 0x7F, 0xE0, 0x00, 0x00, 0x00, 0xFF, 0xF0, 0x00, 0x00, \
0x01, 0xFF, 0xF8, 0x00, 0x00, 0x03, 0xFF, 0xFC, 0x00, 0x00, \
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
};

#endif /* CONF_SYSFONT_H */
