atticus88/SAINTCON-2015-Badge/badge-2015/app/config/shild.h

// Source file: scicon.png

// Image info:  PNG (75, 82) RGBA
// Display controller:  ili9341
#include "gfx.h"
PROGMEM_DECLARE(gfx_color_t, shild_data[6150]) = {
0x0000, 0x0000, 0x0000, 0x0000, 0x0000, 0x0000, 0x0000, 0x0000,
0x0000, 0x0000, 0x0000, 0x0000, 0x0000, 0x0000, 0x0000, 0x0000,
0x0000, 0x0000, 0x0000, 0x0000, 0x0000, 0x0000, 0x0000, 0x0000,
0x0000, 0x0000, 0x0000, 0x0000, 0x0000, 0x0000, 0x0000, 0x0000,
0x0000, 0x0000, 0x0000, 0x0000, 0x0000, 0x0000, 0x0000, 0x0000,
0x0000, 0x0000, 0x0000, 0x0000, 0x0000, 0x0000, 0x0000, 0x0000,
0x0000, 0x0000, 0x0000, 0x0000, 0x0000, 0x0000, 0x0000, 0x0000,
0x0000, 0x0000, 0x0000, 0x0000, 0x0000, 0x0000, 0x0000, 0x0000,
0x0000, 0x0000, 0x0000, 0x0000, 0x0000, 0x0000, 0x0000, 0x0000,
0x0000, 0x0000, 0x0000, 0x1ef0, 0x1ef0, 0x1ef0, 0x1ef0, 0x1ef0,
0x1ef0, 0x1ef0, 0x1ef0, 0x1ef0, 0x1ef0, 0x1ef0, 0x1ef0, 0x1ef0,
0x1ef0, 0x1ef0, 0x1ef0, 0x1ef0, 0x1ef0, 0x1ef0, 0x1ef0, 0x1ef0,
0x1ef0, 0x1ef0, 0x1ef0, 0x1ef0, 0x1ef0, 0x1ef0, 0x1ef0, 0x1ef0,
0x1ef0, 0x1ef0, 0x1ef0, 0x1ef0, 0x1ef0, 0x1ef0, 0x0000, 0x3bd8,
0x5ad0, 0x3de8, 0x1ef0, 0x1ef0, 0x1ef0, 0x1ef0, 0x1ef0, 0x1ef0,
0x1ef0, 0x1ef0, 0x1ef0, 0x1ef0, 0x1ef0, 0x1ef0, 0x1ef0, 0x1ef0,
0x1ef0, 0x1ef0, 0x1ef0, 0x1ef0, 0x1ef0, 0x1ef0, 0x1ef0, 0x1ef0,
0x1ef0, 0x1ef0, 0x1ef0, 0x1ef0, 0x1ef0, 0x1ef0, 0x1ef0, 0x1ef0,
0x1ef0, 0x1ef0, 0x1ef0, 0x1ef0, 0x1ef0, 0x1ef0, 0x1ef0, 0x1ef0,
0x1ef0, 0x1ef0, 0x1ef0, 0x1ef0, 0x1ef0, 0x1ef0, 0x1ef0, 0x1ef0,
0x1ef0, 0x1ef0, 0x1ef0, 0x1ef0, 0x1ef0, 0x1ef0, 0x1ef0, 0x1ef0,
0x1ef0, 0x1ef0, 0x1ef0, 0x1ef0, 0x1ef0, 0x1ef0, 0x1ef0, 0x1ef0,
0x1ef0, 0x1ef0, 0x1ef0, 0x1ef0, 0x1ef0, 0x1ef0, 0x1ef0, 0x0000,
0x3ce0, 0x37b8, 0x8e68, 0xaa50, 0x76b0, 0x3ce0, 0x1ef0, 0x1ef0,
0x1ef0, 0x1ef0, 0x1ef0, 0x1ef0, 0x1ef0, 0x1ef0, 0x1ef0, 0x1ef0,
0x1ef0, 0x1ef0, 0x1ef0, 0x1ef0, 0x1ef0, 0x1ef0, 0x1ef0, 0x1ef0,
0x1ef0, 0x1ef0, 0x1ef0, 0x1ef0, 0x1ef0, 0x1ef0, 0x1ef0, 0x1ef0,
0x1ef0, 0x1ef0, 0x1ef0, 0x1ef0, 0x1ef0, 0x1ef0, 0x1ef0, 0x1ef0,
0x1ef0, 0x1ef0, 0x1ef0, 0x1ef0, 0x1ef0, 0x1ef0, 0x1ef0, 0x1ef0,
0x1ef0, 0x1ef0, 0x1ef0, 0x1ef0, 0x1ef0, 0x1ef0, 0x1ef0, 0x1ef0,
0x1ef0, 0x1ef0, 0x1ef0, 0x1ef0, 0x1ef0, 0x1ef0, 0x1ef0, 0x1ef0,
0x1ef0, 0x1ef0, 0x1ef0, 0x1ef0, 0x1ef0, 0x1ef0, 0x1ef0, 0x1ef0,
0x0000, 0x3ce0, 0x38c0, 0x4f78, 0x4420, 0x2000, 0x2000, 0x2318,
0x2e70, 0x38c0, 0x3ce0, 0x0000, 0x1ef0, 0x1ef0, 0x1ef0, 0x1ef0,
0x1ef0, 0x1ef0, 0x1ef0, 0x1ef0, 0x1ef0, 0x1ef0, 0x1ef0, 0x1ef0,
0x1ef0, 0x1ef0, 0x1ef0, 0x1ef0, 0x1ef0, 0x1ef0, 0x1ef0, 0x1ef0,
0x1ef0, 0x1ef0, 0x1ef0, 0x1ef0, 0x1ef0, 0x1ef0, 0x1ef0, 0x1ef0,
0x1ef0, 0x1ef0, 0x1ef0, 0x1ef0, 0x1ef0, 0x1ef0, 0x1ef0, 0x1ef0,
0x1ef0, 0x1ef0, 0x1ef0, 0x1ef0, 0x1ef0, 0x1ef0, 0x1ef0, 0x1ef0,
0x1ef0, 0x1ef0, 0x1ef0, 0x1ef0, 0x1ef0, 0x1ef0, 0x1ef0, 0x1ef0,
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
};
struct gfx_bitmap shild =  { .width = 75, .height = 82 , .type = GFX_BITMAP_PROGMEM, .data.progmem = (gfx_color_t PROGMEM_PTR_T)shild_data};
