atticus88/SAINTCON-2015-Badge/badge-2015/common/components/wifi/winc1500/driver/source/nmdrv.c

/**
 *
 * \file
 *
 * \brief This module contains NMC1000 M2M driver APIs implementation.
 *
 * Copyright (c) 2015 Atmel Corporation. All rights reserved.
 *
 * \asf_license_start
 *
 * \page License
 *
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
 * 3. The name of Atmel may not be used to endorse or promote products derived
 *    from this software without specific prior written permission.
 *
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
 * \asf_license_stop
 *
 */

#include "common/include/nm_common.h"
#include "driver/source/nmbus.h"
#include "bsp/include/nm_bsp.h"
#include "driver/source/nmdrv.h"
#include "driver/source/nmasic.h"

#ifdef CONF_WINC_USE_SPI
#include "driver/source/nmspi.h"
#endif


#define rHAVE_SDIO_IRQ_GPIO_BIT     (NBIT0)
#define rHAVE_USE_PMU_BIT           (NBIT1)
#define rHAVE_SLEEP_CLK_SRC_RTC_BIT (NBIT2)
#define rHAVE_SLEEP_CLK_SRC_XO_BIT  (NBIT3)
#define rHAVE_EXT_PA_INV_TX_RX      (NBIT4)
#define rHAVE_LEGACY_RF_SETTINGS    (NBIT5)


static sint8 nm_get_firmware_info(tstrM2mRev* M2mRev);




static void chip_apply_conf(void)
{
	sint8 ret = M2M_SUCCESS;

	uint32 val32;
	val32 = 0;
#ifdef __ENABLE_PMU__
	val32 |= rHAVE_USE_PMU_BIT;
#endif
#ifdef __ENABLE_SLEEP_CLK_SRC_RTC__
	val32 |= rHAVE_SLEEP_CLK_SRC_RTC;
#elif defined __ENABLE_SLEEP_CLK_SRC_XO__
	val32 |= rHAVE_SLEEP_CLK_SRC_XO;
#endif
#ifdef __ENABLE_EXT_PA_INV_TX_RX__
	val32 |= rHAVE_EXT_PA_INV_TX_RX;
#endif
#ifdef __ENABLE_LEGACY_RF_SETTINGS__
	val32 |= rHAVE_LEGACY_RF_SETTINGS;
#endif
	do  {
		nm_write_reg(rNMI_GP_REG_1, val32);
		if(val32 != 0) {
			uint32 reg = 0;
			ret = nm_read_reg_with_ret(rNMI_GP_REG_1, &reg);
			if(ret == M2M_SUCCESS) {
				if(reg == val32)
					break;
			}
		} else {
			break;
		}
	} while(1);
}

/*
*	@fn		nm_drv_init_download_mode
*	@brief	Initialize NMC1000 driver
*	@return	M2M_SUCCESS in case of success and Negative error code in case of failure
*   @param [in]	arg
*				Generic argument
*	@author	Viswanathan Murugesan
*	@date	10 Oct 2014
*	@version	1.0
*/
sint8 nm_drv_init_download_mode()
{
	sint8 ret = M2M_SUCCESS;

	ret = nm_bus_iface_init(NULL);
	if (M2M_SUCCESS != ret) {
		M2M_ERR("[nmi start]: fail init bus\n");
		goto ERR1;
	}


#ifdef CONF_WINC_USE_SPI
	/* Must do this after global reset to set SPI data packet size. */
	nm_spi_init();
#endif

	M2M_INFO("Chip ID %lx\n", nmi_get_chipid());

	/*disable all interrupt in ROM (to disable uart) in 2b0 chip*/
	nm_write_reg(0x20300,0);

ERR1:
	return ret;
}

/*
*	@fn		nm_drv_init
*	@brief	Initialize NMC1000 driver
*	@return	M2M_SUCCESS in case of success and Negative error code in case of failure
*   @param [in]	arg
*				Generic argument
*	@author	M. Abdelmawla
*	@date	15 July 2012
*	@version	1.0
*/
sint8 nm_drv_init(void * arg)
{
	tstrM2mRev strtmp;
	sint8 ret = M2M_SUCCESS;
	uint8 u8Mode = M2M_WIFI_MODE_NORMAL;

	if(NULL != arg) {
		if(M2M_WIFI_MODE_CONFIG == *((uint8 *)arg)) {
			u8Mode = M2M_WIFI_MODE_CONFIG;
		} else {
			/*continue running*/
		}
	} else {
		/*continue running*/
	}

	ret = nm_bus_iface_init(NULL);
	if (M2M_SUCCESS != ret) {
		M2M_ERR("[nmi start]: fail init bus\n");
		goto ERR1;
	}

#ifdef BUS_ONLY
	return;
#endif

	ret = chip_wake();
	nm_bsp_sleep(10);
	if (M2M_SUCCESS != ret) {
		M2M_ERR("[nmi start]: fail chip_wakeup\n");
		goto ERR2;
	}

	M2M_INFO("Chip ID %lx\n", nmi_get_chipid());

	/**
	Go...
	**/
	ret = chip_reset();
	if (M2M_SUCCESS != ret) {
		goto ERR2;
	}

#ifdef CONF_WINC_USE_SPI
	/* Must do this after global reset to set SPI data packet size. */
	nm_spi_init();
#endif
	/*return power save to default value*/
	chip_idle();
	//M2M_INFO("Chip ID %x\n", (unsigned int)nmi_get_chipid());

	ret = cpu_start();
	if (M2M_SUCCESS != ret) {
		goto ERR2;
	}

	ret = wait_for_bootrom(u8Mode);
	if (M2M_SUCCESS != ret) {
		goto ERR2;
	}

	ret = wait_for_firmware_start(u8Mode);
	if (M2M_SUCCESS != ret) {
		goto ERR2;
	}

	if(M2M_WIFI_MODE_CONFIG == u8Mode) {
		goto ERR1;
	} else {
		/*continue running*/
	}

	ret = enable_interrupts();
	if (M2M_SUCCESS != ret) {
		M2M_ERR("failed to enable interrupts..\n");
		goto ERR2;
	}
	
	chip_apply_conf();

	nm_get_firmware_info(&strtmp);

	M2M_INFO("Firmware ver   : %u.%u.%u\n", strtmp.u8FirmwareMajor, strtmp.u8FirmwareMinor, strtmp.u8FirmwarePatch);
	M2M_INFO("Min driver ver : %u.%u.%u\n", strtmp.u8DriverMajor, strtmp.u8DriverMinor, strtmp.u8DriverPatch);
	M2M_INFO("Curr driver ver: %u.%u.%u\n", M2M_DRIVER_VERSION_MAJOR_NO, M2M_DRIVER_VERSION_MINOR_NO, M2M_DRIVER_VERSION_PATCH_NO);

	if(strtmp.u8FirmwareMajor != M2M_DRIVER_VERSION_MAJOR_NO
			|| strtmp.u8FirmwareMinor != M2M_DRIVER_VERSION_MINOR_NO)
	{
		ret = M2M_ERR_FW_VER_MISMATCH;
		M2M_ERR("Firmware version mismatch!\n");
	}
	return ret;
ERR2:
	nm_bus_iface_deinit();
ERR1:
	return ret;
}

/*
*	@fn		nm_drv_deinit
*	@brief	Deinitialize NMC1000 driver
*	@author	M. Abdelmawla
*	@date	17 July 2012
*	@version	1.0
*/
sint8 nm_drv_deinit(void * arg)
{
	sint8 ret;

	ret = chip_deinit();
	if (M2M_SUCCESS != ret) {
		M2M_ERR("[nmi stop]: chip_deinit fail\n");
		goto ERR1;
	}

	ret = nm_bus_iface_deinit();
	if (M2M_SUCCESS != ret) {
		M2M_ERR("[nmi stop]: fail init bus\n");
		goto ERR1;
	}
#ifdef CONF_WINC_USE_SPI
	/* Must do this after global reset to set SPI data packet size. */
	nm_spi_deinit();
#endif

ERR1:
	return ret;
}

/**
*	@fn		nm_get_firmware_info(tstrM2mRev* M2mRev)
*	@brief	Get Firmware version info
*	@param [out]	M2mRev
*			    pointer holds address of structure "tstrM2mRev" that contains the firmware version parameters
*   @author		Ahmad.Mohammad.Yahya
*   @date		27 MARCH 2013
*	@version	1.0
*/
static sint8 nm_get_firmware_info(tstrM2mRev* M2mRev)
{
	uint16  curr_drv_ver, min_req_drv_ver,curr_firm_ver;
	uint32	reg = 0;
	sint8	ret = M2M_SUCCESS;

	ret = nm_read_reg_with_ret(NMI_REV_REG, &reg);

	M2mRev->u8DriverMajor	= M2M_GET_DRV_MAJOR(reg);
	M2mRev->u8DriverMinor   = M2M_GET_DRV_MINOR(reg);
	M2mRev->u8DriverPatch	= M2M_GET_DRV_PATCH(reg);
	M2mRev->u8FirmwareMajor	= M2M_GET_FW_MAJOR(reg);
	M2mRev->u8FirmwareMinor = M2M_GET_FW_MINOR(reg);
	M2mRev->u8FirmwarePatch = M2M_GET_FW_PATCH(reg);
	M2mRev->u32Chipid	= nmi_get_chipid();
	
	curr_firm_ver   = M2M_MAKE_VERSION(M2mRev->u8FirmwareMajor, M2mRev->u8FirmwareMinor,M2mRev->u8FirmwarePatch);
	curr_drv_ver    = M2M_MAKE_VERSION(M2M_DRIVER_VERSION_MAJOR_NO, M2M_DRIVER_VERSION_MINOR_NO, M2M_DRIVER_VERSION_PATCH_NO);
	min_req_drv_ver = M2M_MAKE_VERSION(M2mRev->u8DriverMajor, M2mRev->u8DriverMinor,M2mRev->u8DriverPatch);
	if(curr_drv_ver <  min_req_drv_ver) {
		/*The current driver version should be larger or equal 
		than the min driver that the current firmware support  */
		ret = M2M_ERR_FW_VER_MISMATCH;
	}
	if(curr_drv_ver >  curr_firm_ver) {
		/*The current driver should be equal or less than the firmware version*/
		ret = M2M_ERR_FW_VER_MISMATCH;
	}
	return ret;
}
