atticus88/SAINTCON-2015-Badge/badge-2015/badge/esp8266/esp8266_usb_bridge.c

#include "asf.h"
#include "cdc.h"

static volatile bool main_b_cdc_enable = false;

void uart_config(uint8_t port, usb_cdc_line_coding_t * cfg) {
	uint8_t reg_ctrlc;
	uint16_t bsel;

	reg_ctrlc = USART_CMODE_ASYNCHRONOUS_gc;

	switch (cfg->bCharFormat) {
	case CDC_STOP_BITS_2:
		reg_ctrlc |= USART_SBMODE_bm;
		break;
	case CDC_STOP_BITS_1:
	default:
		// Default stop bit = 1 stop bit
		break;
	}

	switch (cfg->bParityType) {
	case CDC_PAR_EVEN:
		reg_ctrlc |= USART_PMODE_EVEN_gc;
		break;
	case CDC_PAR_ODD:
		reg_ctrlc |= USART_PMODE_ODD_gc;
		break;
	default:
	case CDC_PAR_NONE:
		reg_ctrlc |= USART_PMODE_DISABLED_gc;
		break;
	}

	switch (cfg->bDataBits) {
	case 5:
		reg_ctrlc |= USART_CHSIZE_5BIT_gc;
		break;
	case 6:
		reg_ctrlc |= USART_CHSIZE_6BIT_gc;
		break;
	case 7:
		reg_ctrlc |= USART_CHSIZE_7BIT_gc;
		break;
	default:
	case 8:
		reg_ctrlc |= USART_CHSIZE_8BIT_gc;
		break;
	case 9:
		reg_ctrlc |= USART_CHSIZE_9BIT_gc;
		break;
	}

	sysclk_enable_module(USART_PORT_SYSCLK, USART_SYSCLK);
	// Set configuration
	USART.CTRLC = reg_ctrlc;
	// Update baudrate
	bsel = (uint16_t) (((((((uint32_t) sysclk_get_cpu_hz()) << 1) / ((uint32_t)
		le32_to_cpu(cfg->dwDTERate) * 8)) + 1) >> 1) - 1);
	USART.BAUDCTRLA = bsel & 0xFF;
	USART.BAUDCTRLB = bsel >> 8;
}

void uart_open(uint8_t port) {

	sysclk_enable_module(USART_PORT_SYSCLK, USART_SYSCLK);
	// Open UART communication
	USART_PORT.DIRSET = USART_PORT_PIN_TX; // TX as output.
	USART_PORT.DIRCLR = USART_PORT_PIN_RX; // RX as input.

	// Enable both RX and TX
	USART.CTRLB = USART_RXEN_bm | USART_TXEN_bm | USART_CLK2X_bm;
	// Enable interrupt with priority higher than USB
	USART.CTRLA = (register8_t) USART_RXCINTLVL_HI_gc | (register8_t)
			USART_DREINTLVL_OFF_gc;
}

void uart_close(uint8_t port){
	sysclk_disable_module(USART_PORT_SYSCLK, USART_SYSCLK);
	// Disable interrupts
	USART.CTRLA = 0;
	// Close RS232 communication
	USART.CTRLB = 0;
}

void uart_rx_notify(uint8_t port){
	// If UART is open
	if (USART.CTRLA!=0) {
		// Enable UART TX interrupt to send values
		USART.CTRLA = (register8_t) USART_RXCINTLVL_HI_gc | (register8_t)
		USART_DREINTLVL_HI_gc;
	}
}


bool main_cdc_enable(uint8_t port) {
	//LED_On(LED0);
	main_b_cdc_enable = true;
	// Open communication
	uart_open(port);
	return true;
}

void main_cdc_disable(uint8_t port) {
	main_b_cdc_enable = false;
	// Close communication
	uart_close(port);
}

ISR(USART_RX_Vect){
	//LED_Toggle(LED0);
	uint8_t value;

	// Data received
	//ui_com_tx_start();

	if (0 != (USART.STATUS & (USART_FERR_bm | USART_BUFOVF_bm))) {
		udi_cdc_signal_framing_error();
		//ui_com_error();
	}

	// Transfer UART RX fifo to CDC TX
	value = USART.DATA;
	if (!udi_cdc_is_tx_ready()) {
		// Fifo full
		udi_cdc_signal_overrun();
		//ui_com_overflow();
	}else{
		udi_cdc_putc(value);
	}
	//ui_com_tx_stop();
}

ISR(USART_DRE_Vect){
	//LED_Toggle(LED0);
	//LED_On(LED0);
	// Data send
	if (udi_cdc_is_rx_ready()) {
		// Transmit next data
		//ui_com_rx_start();
		USART.DATA = udi_cdc_getc();
	} else {
		// Fifo empty then Stop UART transmission
		USART.CTRLA = (register8_t) USART_RXCINTLVL_HI_gc |
				(register8_t) USART_DREINTLVL_OFF_gc;
		//ui_com_rx_stop();
	}
}
