atticus88/SAINTCON-2015-Badge/badge-2015/app/config/boot.h

// Source file: boot.bmp

// Image info:  BMP (102, 112) RGB
// Display controller:  ili9341
#include "gfx.h"
PROGMEM_DECLARE(gfx_color_t, boot_data[11424]) = {
0x0c63, 0x0c63, 0x0c63, 0x0c63, 0x0c63, 0x0c63, 0x0c63, 0x0c63,
0x0c63, 0x0c63, 0x0c63, 0x0c63, 0x0c63, 0x0c63, 0x0c63, 0x0c63,
0x0c63, 0x0c63, 0x0c63, 0x0c63, 0x0c63, 0x0c63, 0x0c63, 0x0c63,
0x0c63, 0x0c63, 0x0c63, 0x0c63, 0x0c63, 0x0c63, 0x0c63, 0x0c63,
0x0c63, 0x0c63, 0x0c63, 0x0c63, 0x0c63, 0x0c63, 0x0c63, 0x0c63,
0x0c63, 0x0c63, 0x0c63, 0x0c63, 0x0c63, 0x0c63, 0x0c63, 0x0c63,
0x0c63, 0x0c63, 0x0c63, 0x0c63, 0x0c63, 0x0c63, 0x0c63, 0x0c63,
0x0c63, 0x0c63, 0x0c63, 0x0c63, 0x0c63, 0x0c63, 0x0c63, 0x0c63,
0x0c63, 0x0c63, 0x0c63, 0x0c63, 0x0c63, 0x0c63, 0x0c63, 0x0c63,
0x0c63, 0x0c63, 0x0c63, 0x0c63, 0x0c63, 0x0c63, 0x0c63, 0x0c63,
0x0c63, 0x0c63, 0x0c63, 0x0c63, 0x0c63, 0x0c63, 0x0c63, 0x0c63,
0x0c63, 0x0c63, 0x0c63, 0x0c63, 0x0c63, 0x0c63, 0x0c63, 0x0c63,
0x0c63, 0x0c63, 0x0c63, 0x0c63, 0x0c63, 0x0c63, 0x0c63, 0x0c63,
0x0c63, 0x0c63, 0x0c63, 0x0c63, 0x0c63, 0x0c63, 0x0c63, 0x0c63,
0x0c63, 0x0c63, 0x0c63, 0x0c63, 0x0c63, 0x0c63, 0x0c63, 0x0c63,
0x0c63, 0x0c63, 0x0c63, 0x0c63, 0x0c63, 0x0c63, 0x0c63, 0x0c63,
0x0c63, 0x0c63, 0x0c63, 0x0c63, 0x0c63, 0x0c63, 0x0c63, 0x0c63,
0x0c63, 0x0c63, 0x0c63, 0x0c63, 0x0c63, 0x0c63, 0x0c63, 0x0c63,
0x0c63, 0x0c63, 0x0c63, 0x0c63, 0x0c63, 0x0c63, 0x0c63, 0xca5a,
0x6431, 0x6431, 0xca5a, 0x0c63, 0x0c63, 0x0c63, 0x0c63, 0x0c63,
0x0c63, 0x0c63, 0x0c63, 0x0c63, 0x0c63, 0x0c63, 0x0c63, 0x0c63,
0x0c63, 0x0c63, 0x0c63, 0x0c63, 0x0c63, 0x0c63, 0x0c63, 0x0c63,
0x0c63, 0x0c63, 0x0c63, 0x0c63, 0x0c63, 0x0c63, 0x0c63, 0x0c63,
0x0c63, 0x0c63, 0x0c63, 0x0c63, 0x0c63, 0x0c63, 0x0c63, 0x0c63,
0x0c63, 0x0c63, 0x0c63, 0x0c63, 0x0c63, 0x0c63, 0x0c63, 0x0c63,
0x0c63, 0x0c63, 0x0c63, 0x0c63, 0x0c63, 0x0c63, 0x0c63, 0x0c63,
0x0c63, 0x0c63, 0x0c63, 0x0c63, 0x0c63, 0x0c63, 0x0c63, 0x0c63,
0x0c63, 0x0c63, 0x0c63, 0x0c63, 0x0c63, 0x0c63, 0x0c63, 0x0c63,
0x0c63, 0x0c63, 0x0c63, 0x0c63, 0x0c63, 0x0c63, 0x0c63, 0x0c63,
0x0c63, 0x0c63, 0x0c63, 0x0c63, 0x0c63, 0x0c63, 0x0c63, 0x0c63,
0x0c63, 0x0c63, 0x0c63, 0x0c63, 0x0c63, 0x0c63, 0x0c63, 0x0c63,
0x0c63, 0x0c63, 0x0c63, 0xca5a, 0xe639, 0x8110, 0x2000, 0x2000,
0x8110, 0xe639, 0xcb5a, 0x0c63, 0x0c63, 0x0c63, 0x0c63, 0x0c63,
0x0c63, 0x0c63, 0x0c63, 0x0c63, 0x0c63, 0x0c63, 0x0c63, 0x0c63,
0x0c63, 0x0c63, 0x0c63, 0x0c63, 0x0c63, 0x0c63, 0x0c63, 0x0c63,
0x0c63, 0x0c63, 0x0c63, 0x0c63, 0x0c63, 0x0c63, 0x0c63, 0x0c63,
0x0c63, 0x0c63, 0x0c63, 0x0c63, 0x0c63, 0x0c63, 0x0c63, 0x0c63,
0x0c63, 0x0c63, 0x0c63, 0x0c63, 0x0c63, 0x0c63, 0x0c63, 0x0c63,
0x0c63, 0x0c63, 0x0c63, 0x0c63, 0x0c63, 0x0c63, 0x0c63, 0x0c63,
0x0c63, 0x0c63, 0x0c63, 0x0c63, 0x0c63, 0x0c63, 0x0c63, 0x0c63,
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
};
struct gfx_bitmap boot =  { .width = 102, .height = 112 , .type = GFX_BITMAP_PROGMEM, .data.progmem = (gfx_color_t PROGMEM_PTR_T)boot_data};
