atticus88/SAINTCON-2015-Badge/badge-2015/tools/scsntp.lua

-- https://github.com/DiUS/nodemcu-firmware/wiki/sntp-module-documentation

-- Example: require("sntp"):show_ustamp()
local moduleName = ...

return function ()
	sntp.sync("137.190.2.4",function(ntpstamp)
		print (ntpstamp)
	end)
	package.loaded[moduleName]=nil
	moduleName = nil
end
