atticus88/SAINTCON-2015-Badge/(commit log)

2015-10-30 Inital commit
    [default_gain_setting.csv, samw25_gain_setting.csv]
2015-10-31 Initial add of hardware files
    These were the versions of the hardware files that we used to go to
    production.
    [20150830_saintcon2015_badge-BOM.csv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]
